jesusHA55/mitochondria_tEDE/medulla/bms.kicad_sch

## KiCad design medulla/bms.kicad_sch (2026-03-17)

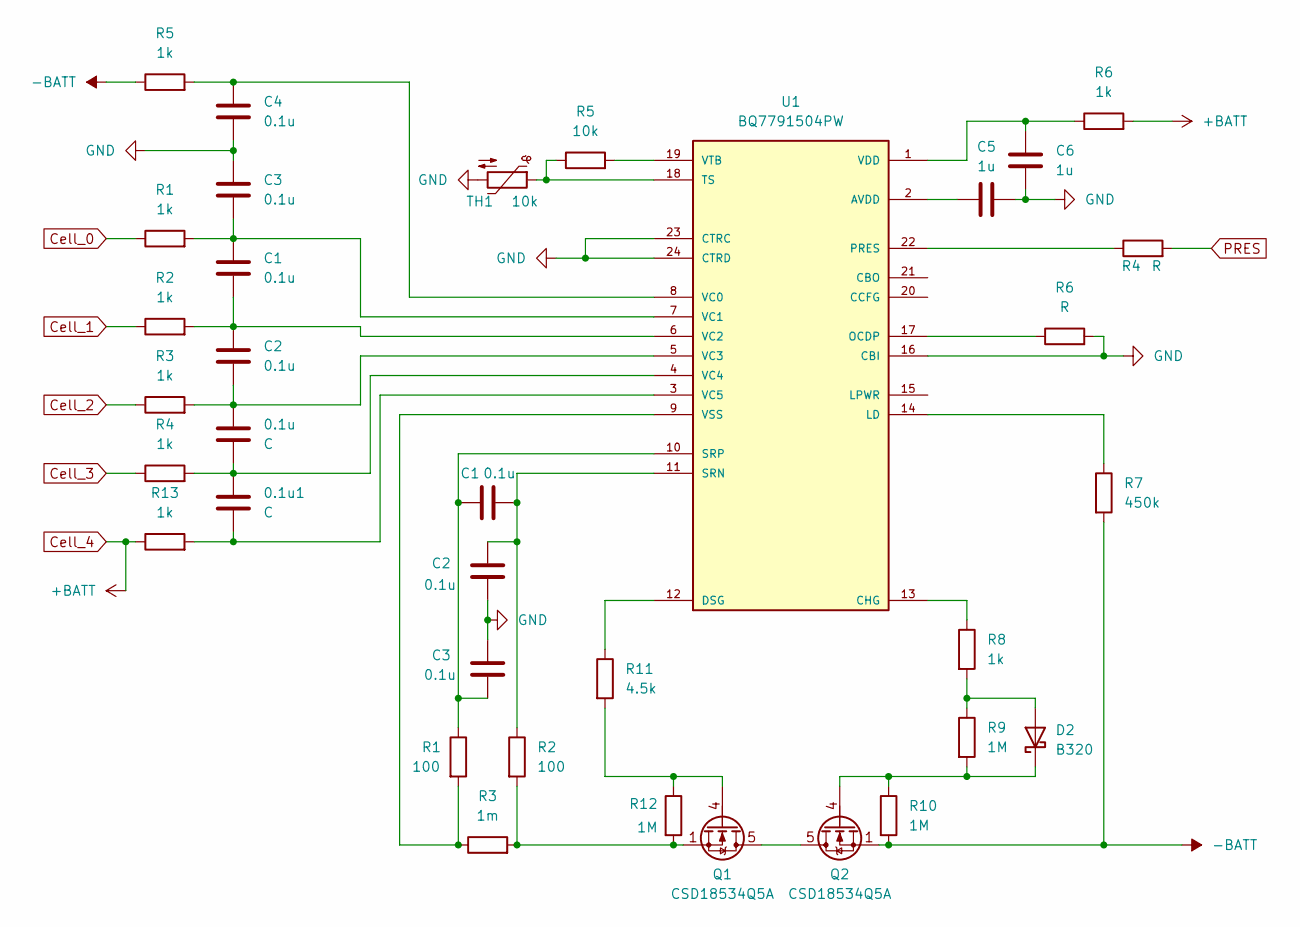
[picture p1: schematic bms.kicad_sch]

Parts:
0.1u, 0.1u1: C
C1, C2, C3, C4: 0.1u
C5, C6: 1u
D2: B320; D_SMC
Q1, Q2: CSD18534Q5A; TDSON-8-1
R1: 100
R2, R8, R13: 1k
R3: 1m
R4, R6: R
R5: 10k
R7: 450k
R9, R10, R12: 1M
R11: 4.5k
TH1: 10k
U1: BQ7791504PW; SOP65P640X120-24N; DigiKey_Part_Number 296-BQ7791504PW-ND

Connections:
+BATT: R6.2, R13.1
-BATT: Q2.1 (S), Q2.2 (S), Q2.3 (S), R5.1, R7.2, R10.2
Cell_0: R1.1
Cell_1: R2.1
Cell_2: R3.1
Cell_3: R4.1
GND: C2.2, C3.1, C4.2, C5.2, C6.2, R6.2, TH1.2, U1.16 (CBI), U1.23 (CTRC), U1.24 (CTRD)
unnamed: 0.1u1.2, R13.2, U1.3 (VC5)
unnamed: 0.1u.1, C2.2, R3.2, U1.5 (VC3)
unnamed: 0.1u.2, 0.1u1.1, R4.2, U1.4 (VC4)
unnamed: C1.1, C3.2, R1.1, R1.2, U1.7 (VC1), U1.10 (SRP)
unnamed: C1.2, C2.1, R2.1, R2.2, U1.6 (VC2), U1.11 (SRN)
unnamed: C4.1, R5.2, U1.8 (VC0)
unnamed: C5.1, U1.2 (AVDD)
unnamed: C6.1, R6.1, U1.1 (VDD)
unnamed: D2.1 (K), Q2.4 (G), R9.2, R10.1
unnamed: D2.2 (A), R8.2, R9.1
unnamed: Q1.1 (S), Q1.2 (S), Q1.3 (S), R2.2, R3.2, R12.2
unnamed: Q1.4 (G), R11.2, R12.1
unnamed: Q1.5 (D), Q2.5 (D)
unnamed: R1.2, R3.1, U1.9 (VSS)
unnamed: R4.1, U1.22 (PRES)
unnamed: R5.1, TH1.1, U1.18 (TS)
unnamed: R5.2, U1.19 (VTB)
unnamed: R6.1, U1.17 (OCDP)
unnamed: R7.1, U1.14 (LD)
unnamed: R8.1, U1.13 (CHG)
unnamed: R11.1, U1.12 (DSG)
PRES: R4.2
