jesusHA55/mitochondria_tEDE/medulla/cond.kicad_sch

## KiCad design medulla/cond.kicad_sch (2026-03-17)

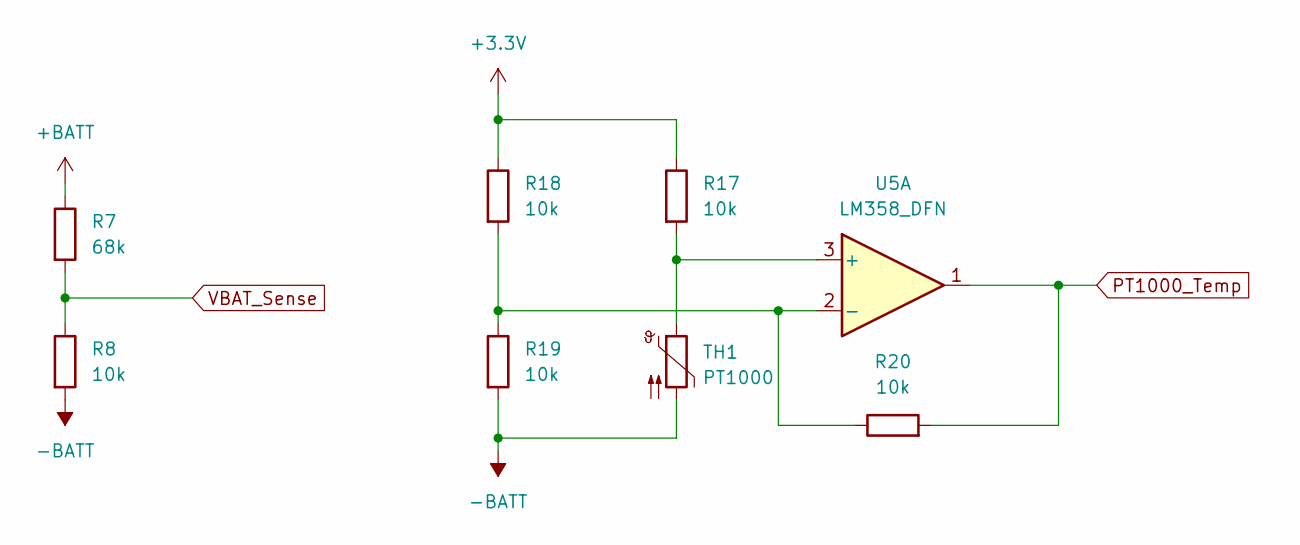
[picture p2: schematic cond.kicad_sch]

Parts:
R7: 68k
R8, R17, R18, R19, R20: 10k
TH1: PT1000
U5: LM358_DFN; DFN-8-1EP_2x2mm_P0.5mm_EP1.05x1.75mm

Connections:
+3.3V: R17.1, R18.1
+BATT: R7.1
-BATT: R8.2, R19.2, TH1.2
unnamed: R17.2, TH1.1, U5.3 (+)
unnamed: R18.2, R19.1, R20.1, U5.2 (-)
PT1000_Temp: R20.2, U5.1
VBAT_Sense: R7.2, R8.1
