jesusHA55/mitochondria_tEDE/medulla/conn.kicad_sch

## KiCad design medulla/conn.kicad_sch (2026-03-26)

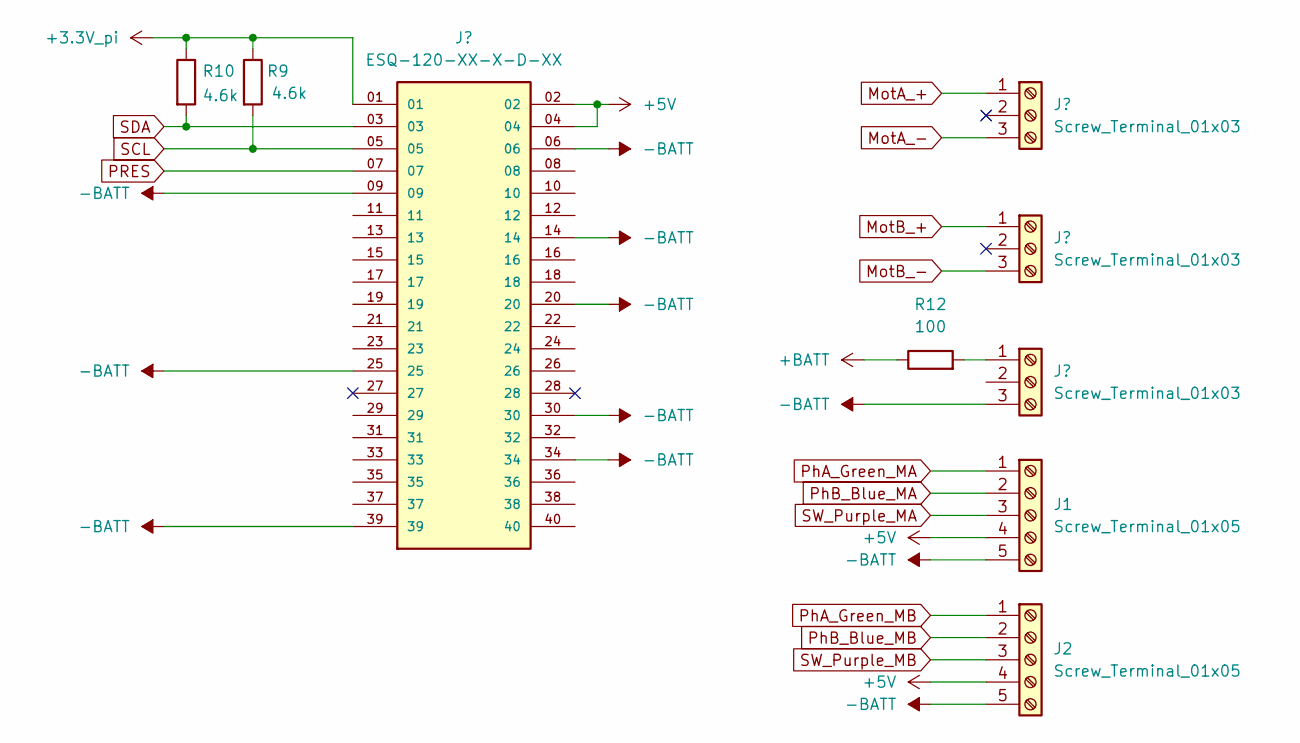
[picture p3: schematic conn.kicad_sch]

Parts:
J1, J2: Screw_Terminal_01x05
R9, R10: 4.6k
R12: 100

Connections:
+5V: J1.4, J2.4
+BATT: R12.1
-BATT: J1.5, J2.5
unnamed: R9.1, R10.1
PhA_Green_MA: J1.1
PhA_Green_MB: J2.1
PhB_Blue_MA: J1.2
PhB_Blue_MB: J2.2
SCL: R9.2
SDA: R10.2
SW_Purple_MA: J1.3
SW_Purple_MB: J2.3
