jesusHA55/mitochondria_tEDE/medulla/pd.kicad_sch

## KiCad design medulla/pd.kicad_sch (2026-03-17)

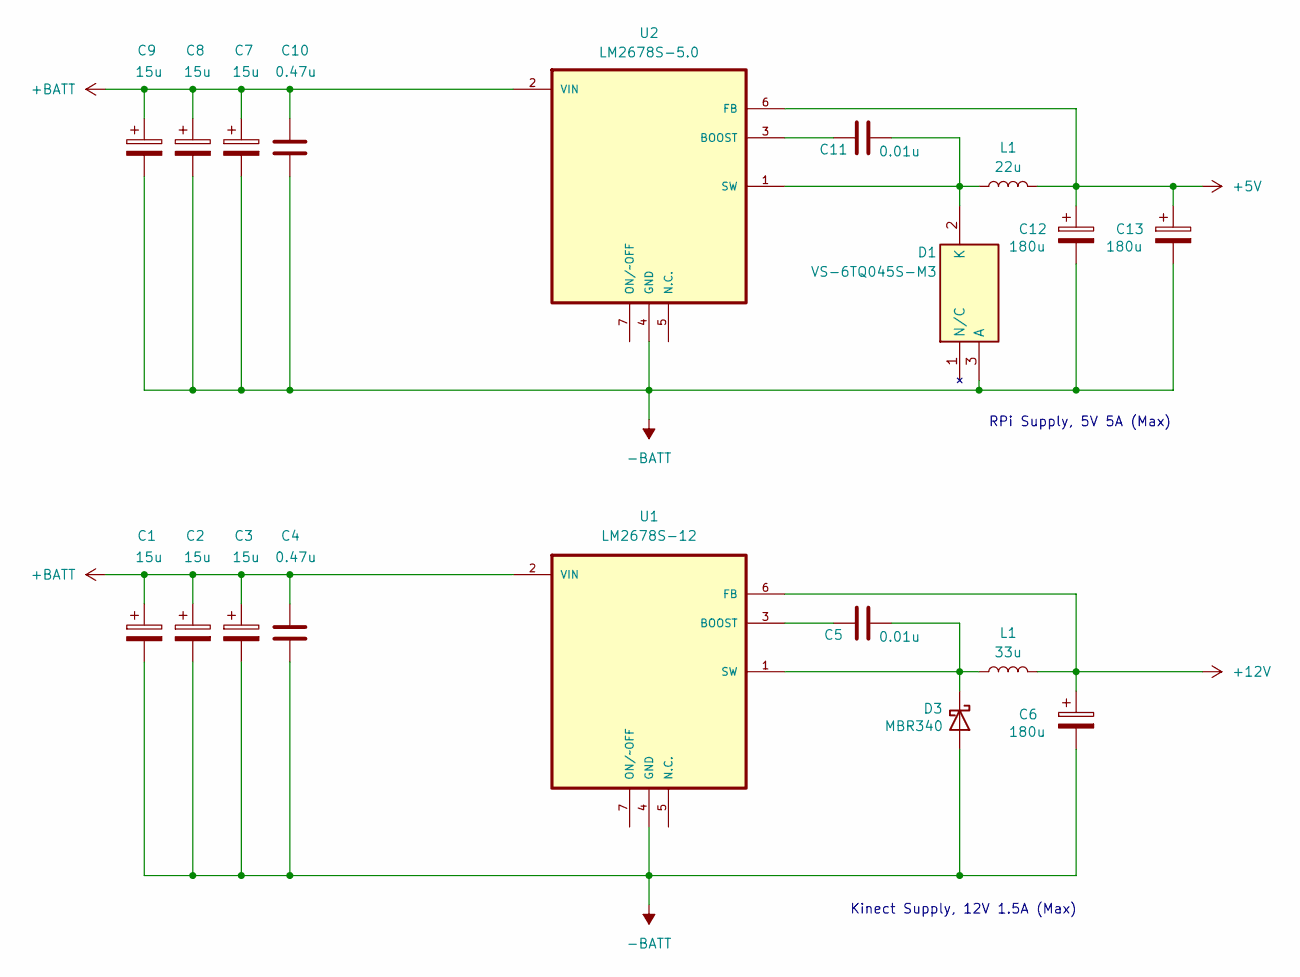
[picture p5: schematic pd.kicad_sch]

Parts:
C1, C2, C3, C7, C8, C9: 15u
C4, C10: 0.47u
C5, C11: 0.01u
C6, C12, C13: 180u
D1: VS-6TQ045S-M3; VS6TQ045SM3; Mouser Part Number 78-VS-6TQ045S-M3
D3: MBR340; D_DO-201AD_P15.24mm_Horizontal
L1: 33u
U1: LM2678S-12; TO127P1435X464-8N
U2: LM2678S-5.0; TO127P1435X464-8N

Connections:
+5V: C12.1, C13.1, L1.2, U2.6 (FB)
+12V: C6.1, L1.2, U1.6 (FB)
+BATT: C1.1, C2.1, C3.1, C4.1, C7.1, C8.1, C9.1, C10.1, U1.2 (VIN), U2.2 (VIN)
-BATT: C1.2, C2.2, C3.2, C4.2, C6.2, C7.2, C8.2, C9.2, C10.2, C12.2, C13.2, D1.3 (A), D3.2 (A), U1.4 (GND), U1.8 (GND), U2.4 (GND), U2.8 (GND)
unnamed: C5.1, U1.3 (BOOST)
unnamed: C5.2, D3.1 (K), L1.1, U1.1 (SW)
unnamed: C11.1, U2.3 (BOOST)
unnamed: C11.2, D1.2 (K), L1.1, U2.1 (SW)

Notes on the sheet:
Kinect Supply, 12V 1.5A (Max)
RPi Supply, 5V 5A (Max)
