jesusHA55/mitochondria_tEDE/medulla/per.kicad_sch

## KiCad design medulla/per.kicad_sch (2026-03-17)

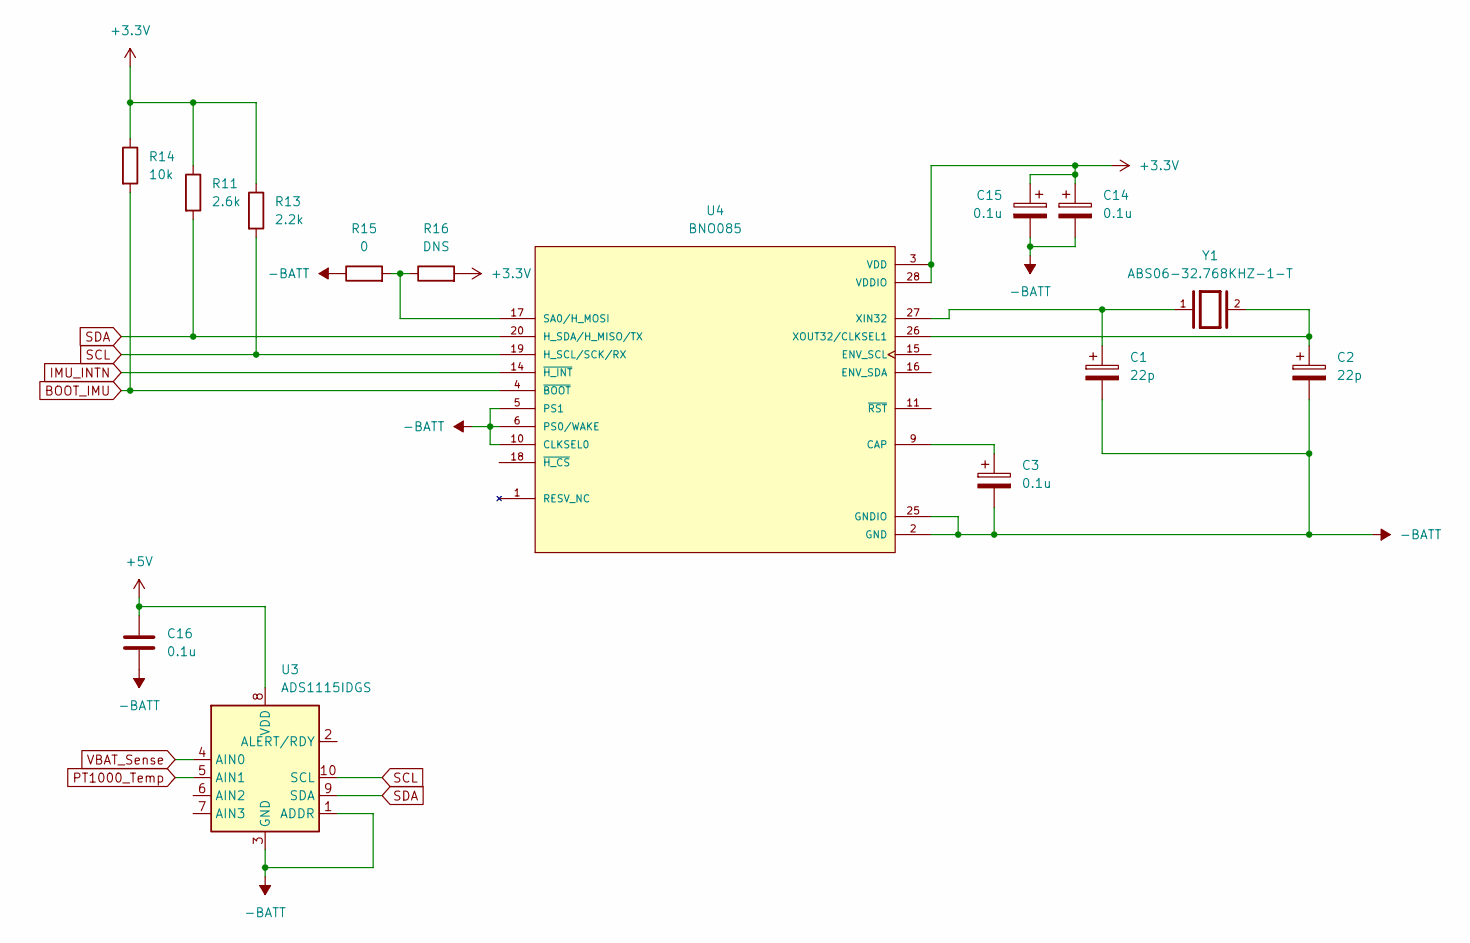
[picture p6: schematic per.kicad_sch]

Parts:
C1, C2: 22p
C3, C14, C15, C16: 0.1u
R11: 2.6k
R13: 2.2k
R14: 10k
R15: 0
R16: DNS
U3: ADS1115IDGS; TSSOP-10_3x3mm_P0.5mm
U4: BNO085; IC_BNO085; PARTREV v1.17
Y1: ABS06-32.768KHZ-1-T; XTAL_ABS06-32.768KHZ-1-T; PARTREV 4/25/2022

Connections:
+3.3V: C14.1, C15.1, R11.1, R13.1, R14.1, R16.2, U4.3 (VDD), U4.28 (VDDIO)
+5V: C16.1, U3.8 (VDD)
-BATT: C1.2, C2.2, C3.2, C14.2, C15.2, C16.2, R15.1, U3.1 (ADDR), U3.3 (GND), U4.2 (GND), U4.5 (PS1), U4.6 (PS0/WAKE), U4.10 (CLKSEL0), U4.25 (GNDIO)
BOOT_IMU: R14.2, U4.4 (~BOOT)
IMU_INTN: U4.14 (~H_INT)
unnamed: C1.1, U4.27 (XIN32), Y1.1
unnamed: C2.1, U4.26 (XOUT32/CLKSEL1), Y1.2
unnamed: C3.1, U4.9 (CAP)
unnamed: R15.2, R16.1, U4.17 (SA0/H_MOSI)
unnamed: U4.1 (RESV_NC), U4.7 (RESV_NC), U4.8 (RESV_NC), U4.12 (RESV_NC), U4.13 (RESV_NC), U4.21 (RESV_NC), U4.22 (RESV_NC), U4.23 (RESV_NC), U4.24 (RESV_NC)
PT1000_Temp: U3.5 (AIN1)
SCL: R13.2, U3.10 (SCL), U4.19 (H_SCL/SCK/RX)
SDA: R11.2, U3.9 (SDA), U4.20 (H_SDA/H_MISO/TX)
VBAT_Sense: U3.4 (AIN0)
