jesusHA55/mitochondria_tEDE/(commit log)

2026-03-16 Added Samac (Mouser components) & 5V Power distribution
    [pd.kicad_sch]
2026-03-16 Added 12V DCDC, GPIO connection, related components to library
    [conn.kicad_sch, pd.kicad_sch]
2026-03-17 0.1.3-alpha: H-Bridge Completion & I2C Sensor integration
    [bms.kicad_sch, cond.kicad_sch, conn.kicad_sch, md.kicad_sch, medulla.kicad_sch, pd.kicad_sch, per.kicad_sch]
2026-03-26 0.2.1-alpha: Minor connector changes
    [conn.kicad_sch]
